lesurJ/ESK8/skate rapport/VESC.jpg

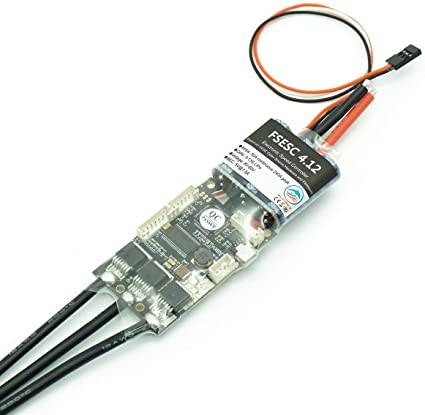
skate rapport/VESC.jpg
