lesurJ/ESK8/skate rapport/abec11-flywheels-97-mm-wheels.jpg

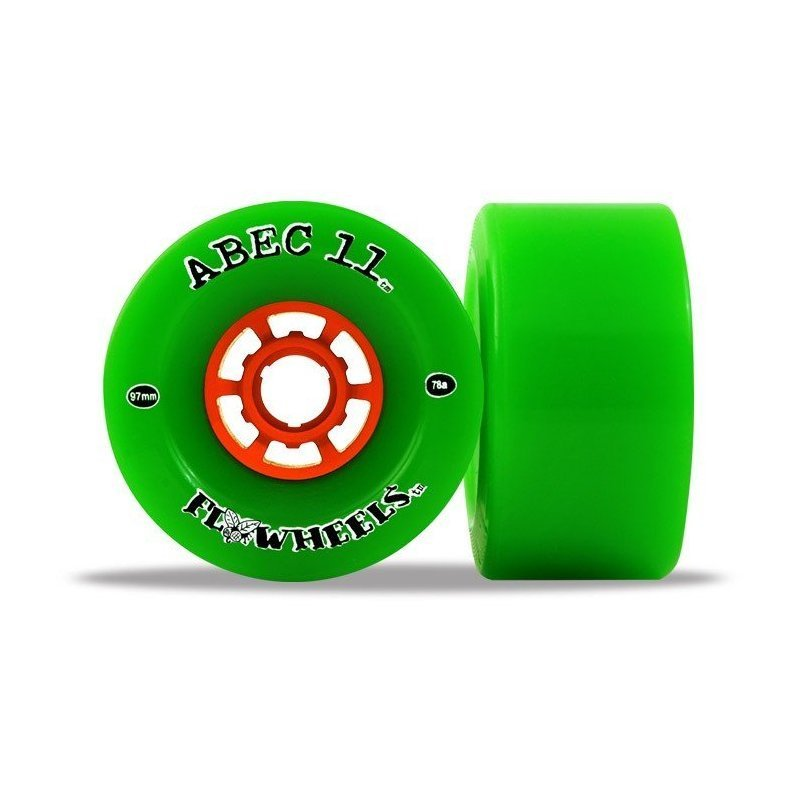
skate rapport/abec11-flywheels-97-mm-wheels.jpg
