lesurJ/ESK8/skate rapport/gt2b.jpeg

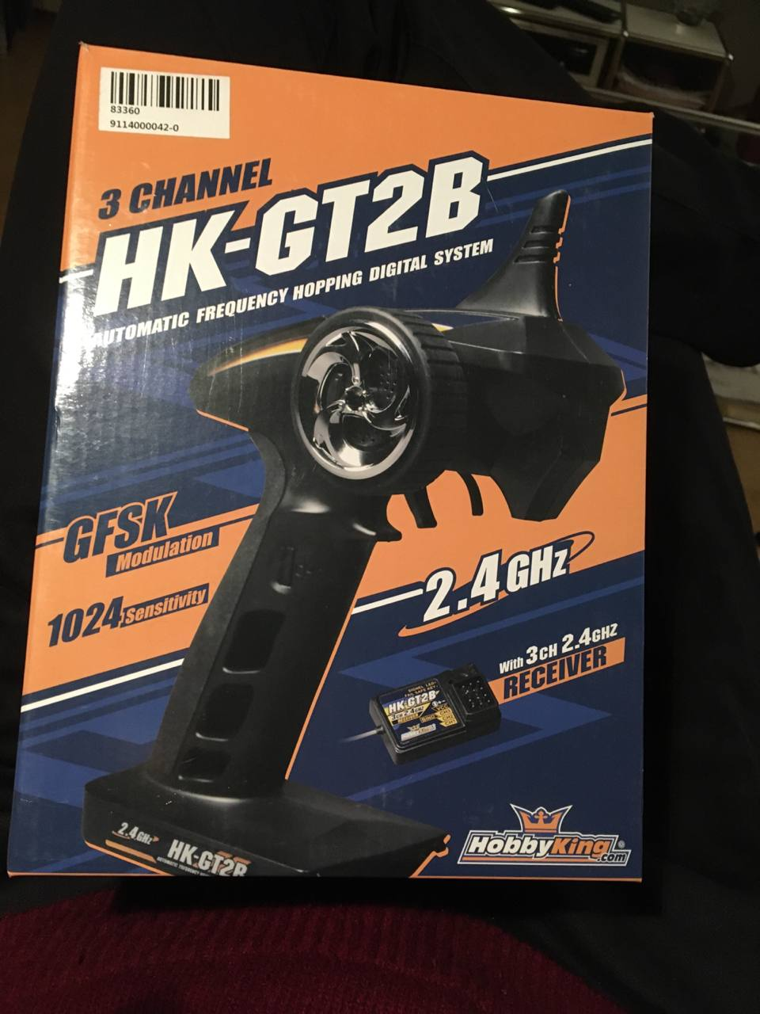
skate rapport/gt2b.jpeg
