lesurJ/ESK8/skate rapport/photo_2021-03-14 20.49.48.jpeg

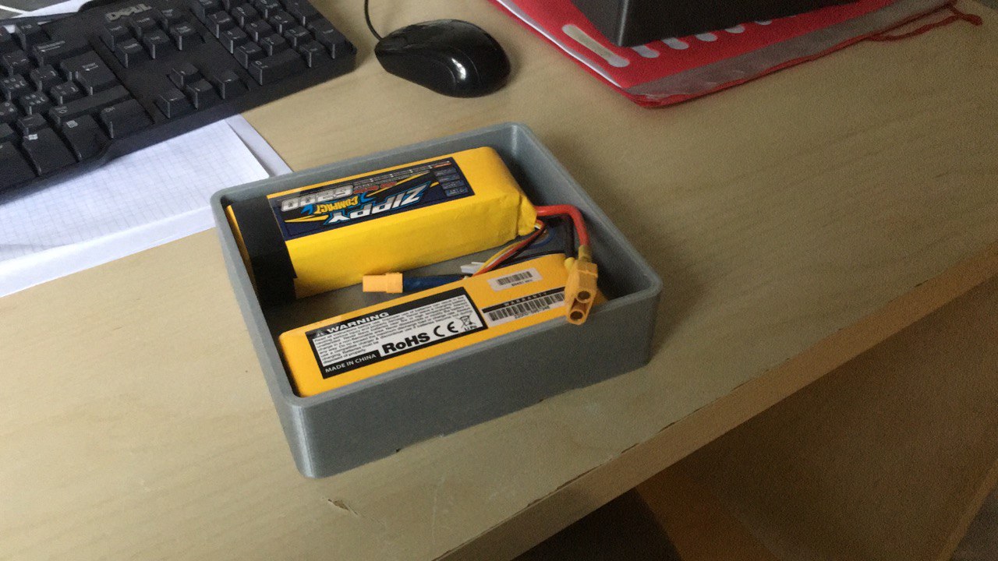
skate rapport/photo_2021-03-14 20.49.48.jpeg
