lesurJ/ESK8/skate rapport/photo_2021-03-14 20.50.11.jpeg

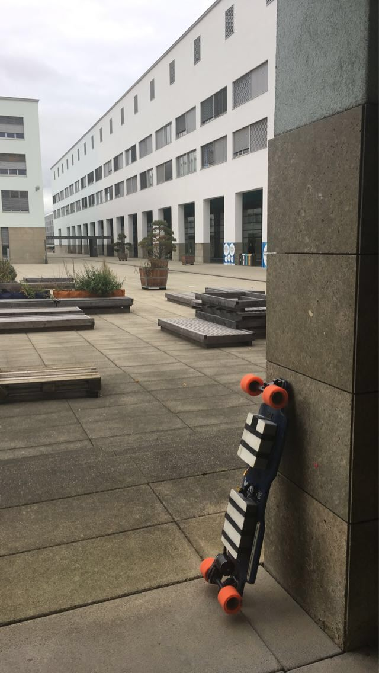
skate rapport/photo_2021-03-14 20.50.11.jpeg
