lesurJ/ESK8/skate rapport/photo_2021-03-14 21.30.39.jpeg

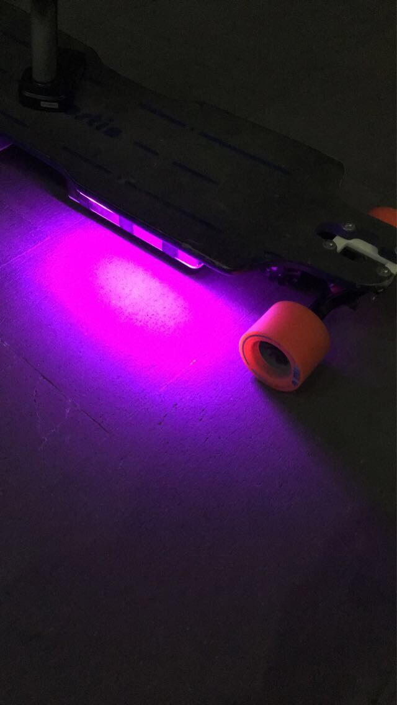
skate rapport/photo_2021-03-14 21.30.39.jpeg
