lesurJ/ESK8/3D parts/BOXES/control_flat_box.stl

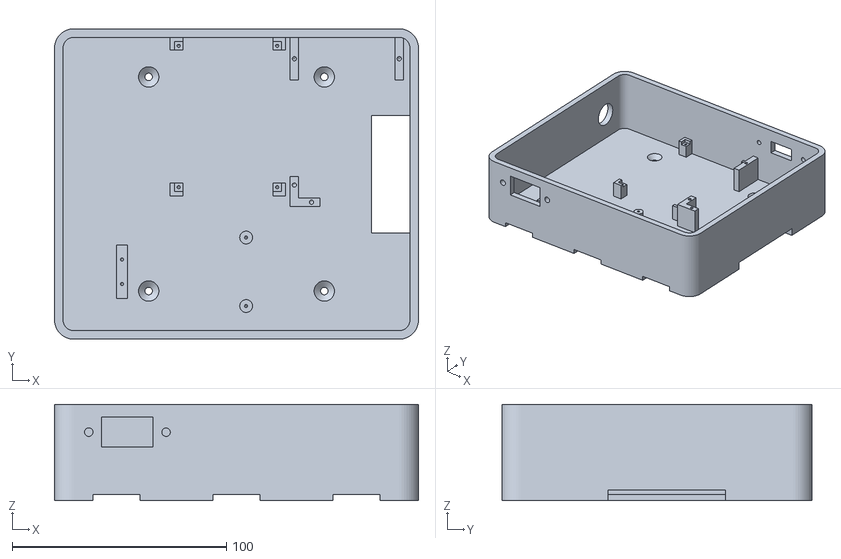
[picture p47: CAD file, 2021-03-15]
3D parts/BOXES/control_flat_box.stl
170.0 x 145.0 x 45.0
