lesurJ/ESK8/3D parts/LEDS/LED_ARR.stl

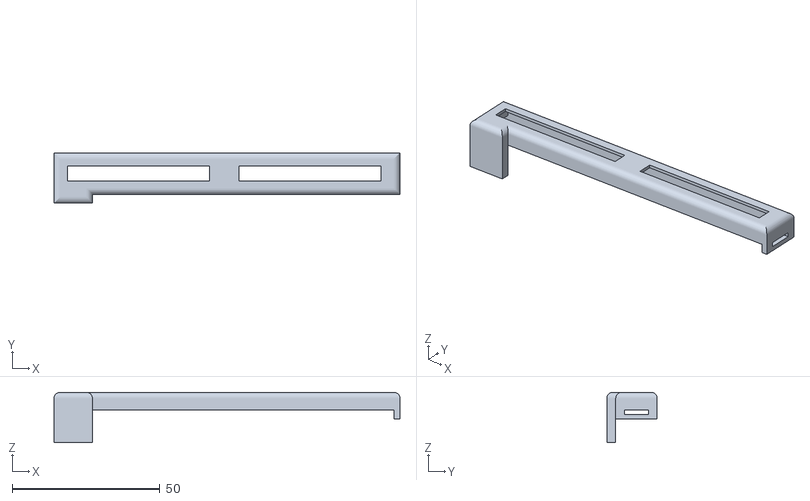
[picture p48: CAD file, 2021-03-15]
3D parts/LEDS/LED_ARR.stl
117.0 x 17.0 x 17.0
