lesurJ/ESK8/3D parts/pad_arr_ecran.stl

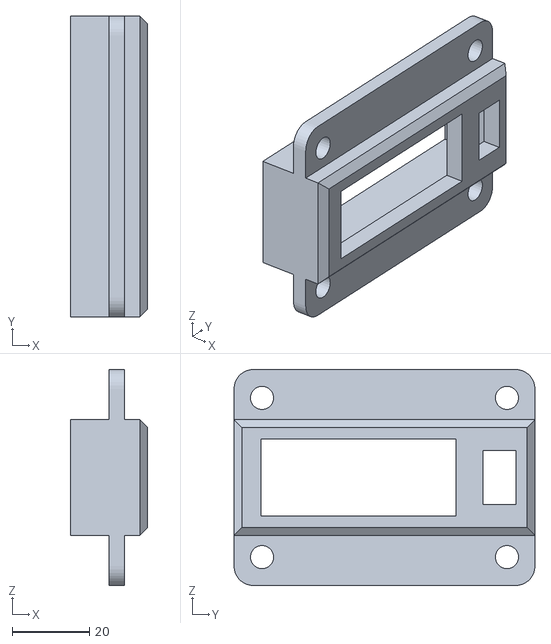
[picture p49: CAD file, 2021-03-15]
3D parts/pad_arr_ecran.stl
20.0 x 78.0 x 56.0
