lesurJ/ESK8/3D parts/BOXES/BAT_BOX_V2.stl

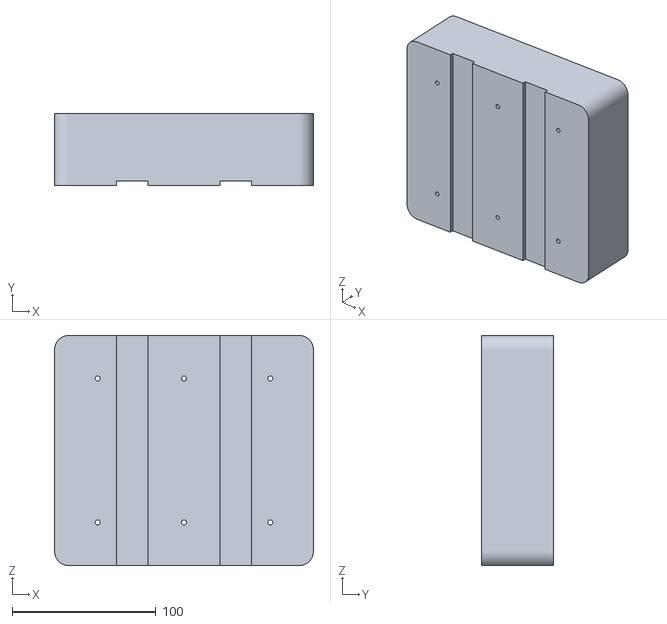
[picture p50: CAD file, 2021-03-15]
3D parts/BOXES/BAT_BOX_V2.stl
180.0 x 50.0 x 160.0
