lesurJ/ESK8/3D parts/LEDS/LEDS.stl

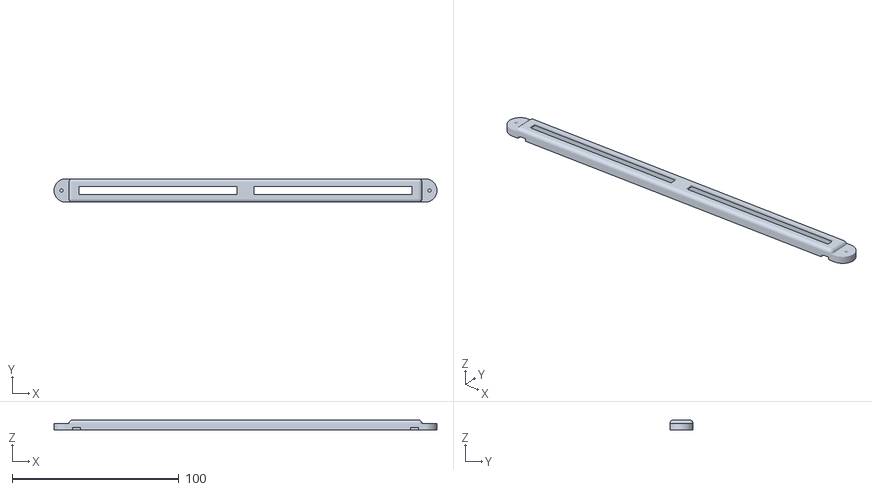
[picture p51: CAD file, 2021-03-15]
3D parts/LEDS/LEDS.stl
230.0 x 14.0 x 6.00
