lesurJ/ESK8/3D parts/PAD_AV.stl

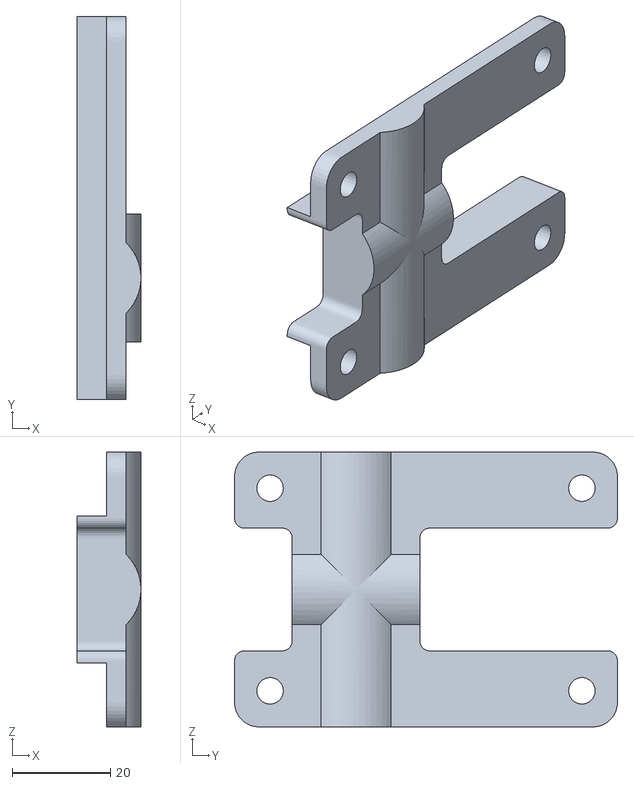
[picture p52: CAD file, 2021-03-15]
3D parts/PAD_AV.stl
13.0 x 78.0 x 56.0
