lesurJ/ESK8/3D parts/BOXES/CONTROL_BOX.stl

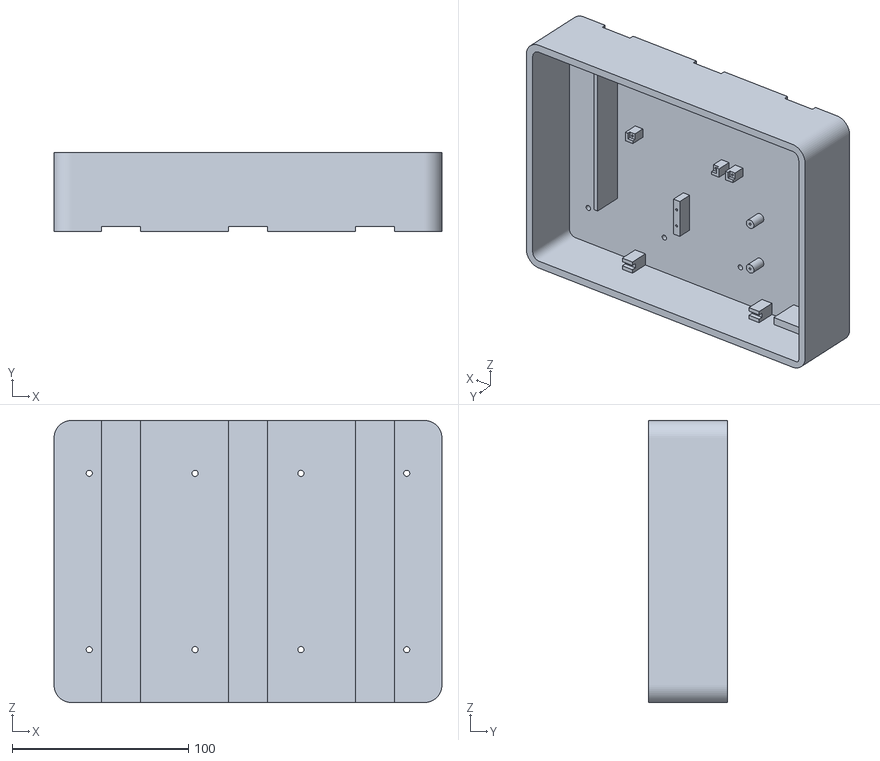
[picture p53: CAD file, 2021-03-15]
3D parts/BOXES/CONTROL_BOX.stl
220.0 x 45.0 x 160.0
