lesurJ/ESK8/3D parts/LEDS/SUPPORT_ARR_V2.stl

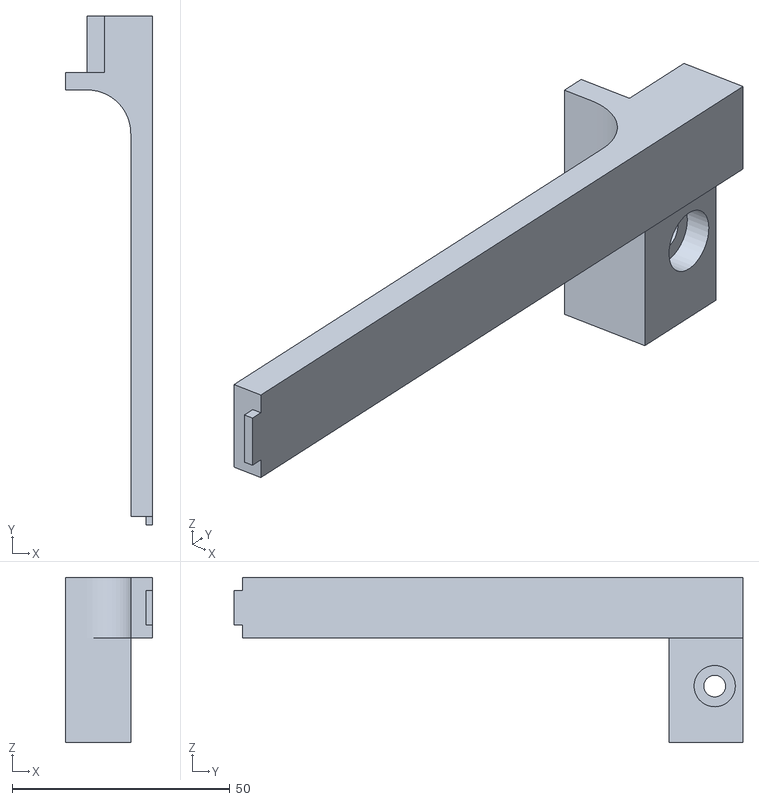
[picture p54: CAD file, 2021-03-15]
3D parts/LEDS/SUPPORT_ARR_V2.stl
20.0 x 117.0 x 38.0
