lesurJ/ESK8/3D parts/RISER.stl

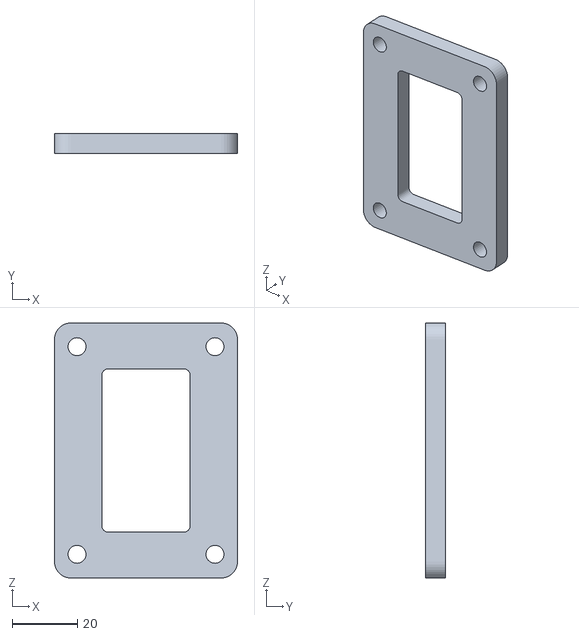
[picture p55: CAD file, 2021-03-15]
3D parts/RISER.stl
56.0 x 6.00 x 78.0
