lesurJ/ESK8/3D parts/XT90_-_Empty.stl

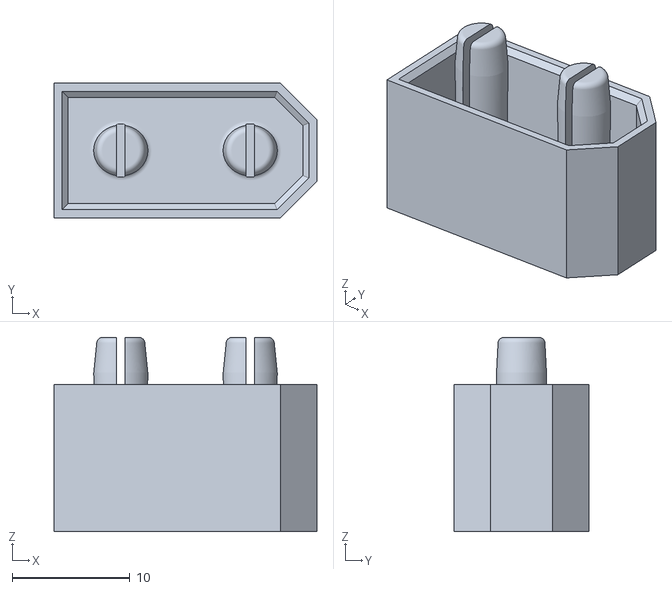
[picture p57: CAD file, 2021-03-15]
3D parts/XT90_-_Empty.stl
22.3 x 11.5 x 16.5
