lesurJ/ESK8/3D parts/BOXES/CONTROL_BOX_CAP.stl

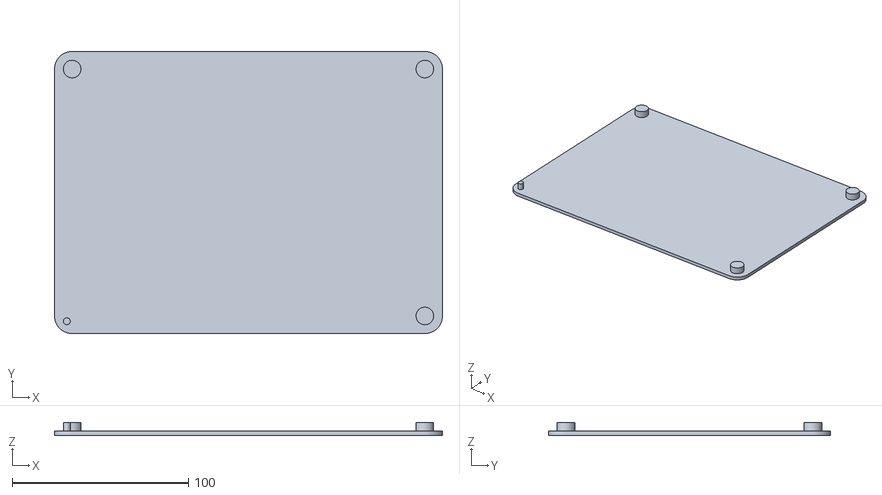
[picture p58: CAD file, 2021-03-15]
3D parts/BOXES/CONTROL_BOX_CAP.stl
220.0 x 160.0 x 7.50
