lesurJ/ESK8/3D parts/BOXES/flat_box_cap.stl

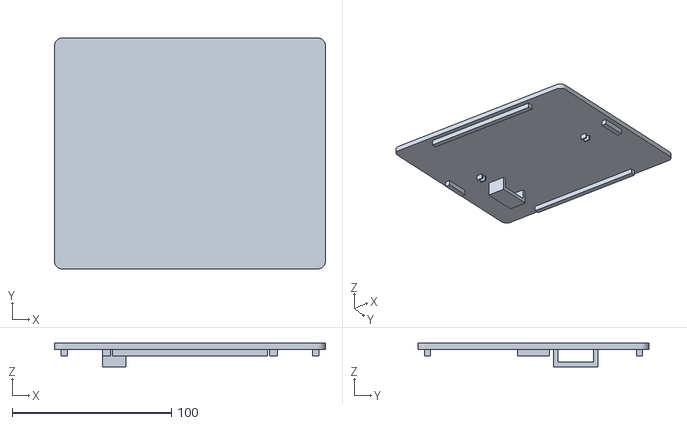
[picture p59: CAD file, 2021-03-15]
3D parts/BOXES/flat_box_cap.stl
170.0 x 145.0 x 15.0
