lesurJ/ESK8/(list of files, cad)

Other CAD files:
3D parts/BOXES/BAT_BOX_CAP_V2.CATPart
3D parts/BOXES/BAT_BOX_V2.CATPart
3D parts/BOXES/CONTROL_BOX.CATPart
3D parts/BOXES/CONTROL_BOX_CAP.CATPart
3D parts/BOXES/control_flat_box.CATPart
3D parts/BOXES/flat_box_cap.CATPart
3D parts/LEDS/LEDS.CATPart
3D parts/LEDS/LED_ARR.CATPart
3D parts/LEDS/SUPPORT_ARR_LED.CATPart
3D parts/PAD_ARR_ECRAN.CATPart
3D parts/PAD_AV.CATPart
3D parts/RISER.CATPart
