lesurJ/ESK8/(commit log)

2021-03-08 addded colors for led switch
2021-03-15 update the README as well as the 3D parts folder
    [BAT_BOX_CAP_V2.CATPart, BAT_BOX_CAP_V2.stl, BAT_BOX_V2.CATPart, BAT_BOX_V2.stl, CONTROL_BOX.CATPart, CONTROL_BOX.stl, CONTROL_BOX_CAP.CATPart, CONTROL_BOX_CAP.stl]
2021-06-03 updated code with led animations
